jas03/LED-cube/README.md

# LED-cube
Design project for ECE-411

A 3x3x3 tricolor LED Cube that responds to music.

Members:

Evan Yand
Matthew Konyndyk
Alex Mendez
Jasjit Singh
