jas03/LED-cube/project_images/Atmega328.png

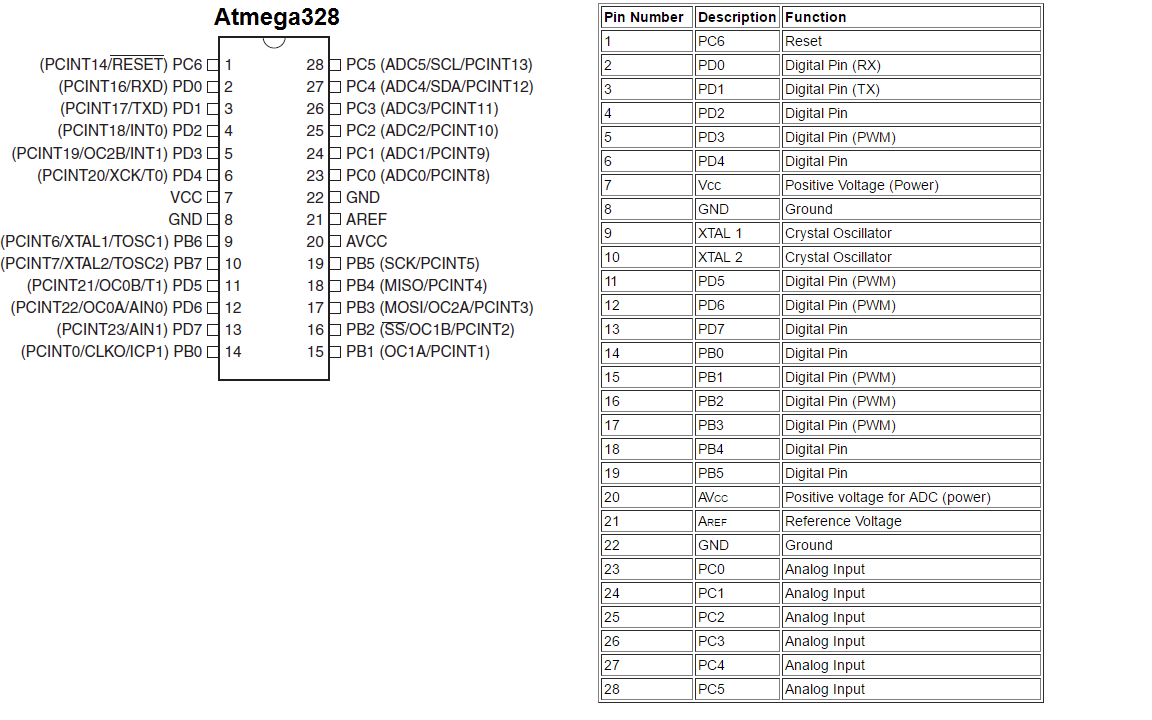
project_images/Atmega328.png
