jas03/LED-cube/project_images/atmega328_breadboard.png

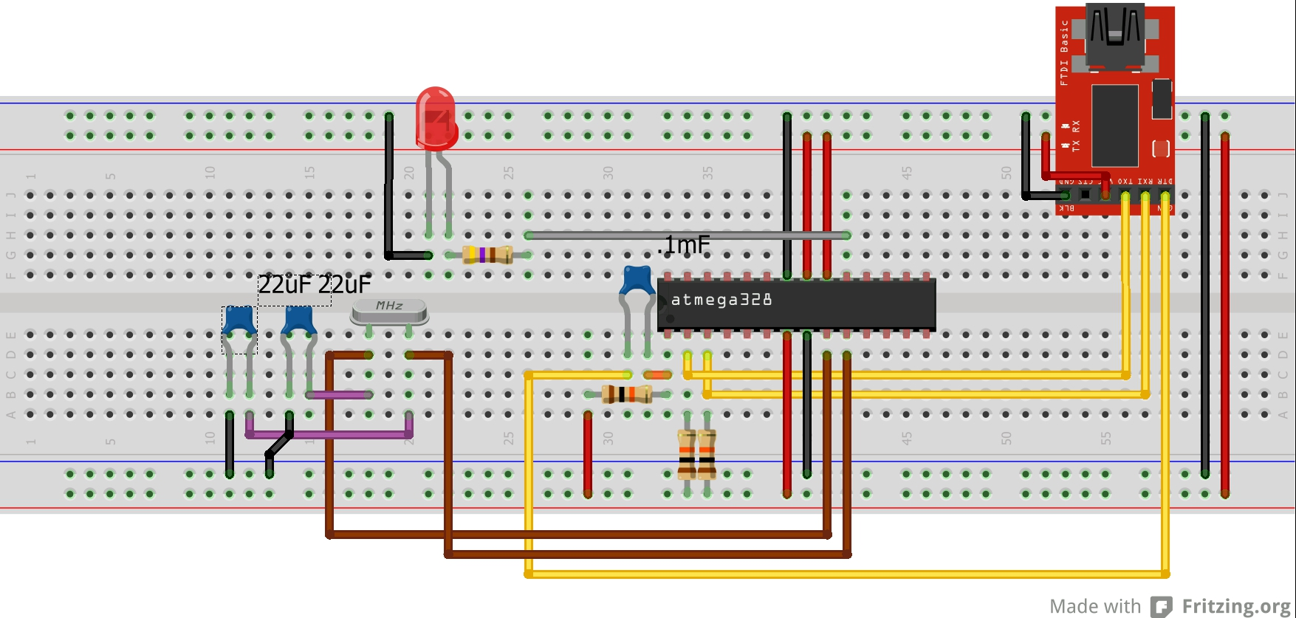
project_images/atmega328_breadboard.png
