jas03/LED-cube/project_images/Bread-Board-Arduino-Circuit.png

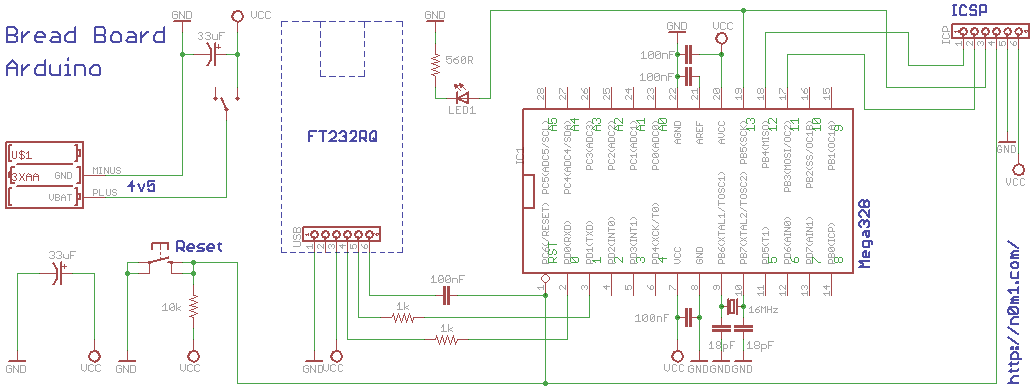
project_images/Bread-Board-Arduino-Circuit.png
