jas03/LED-cube/project_images/msgeq7.png

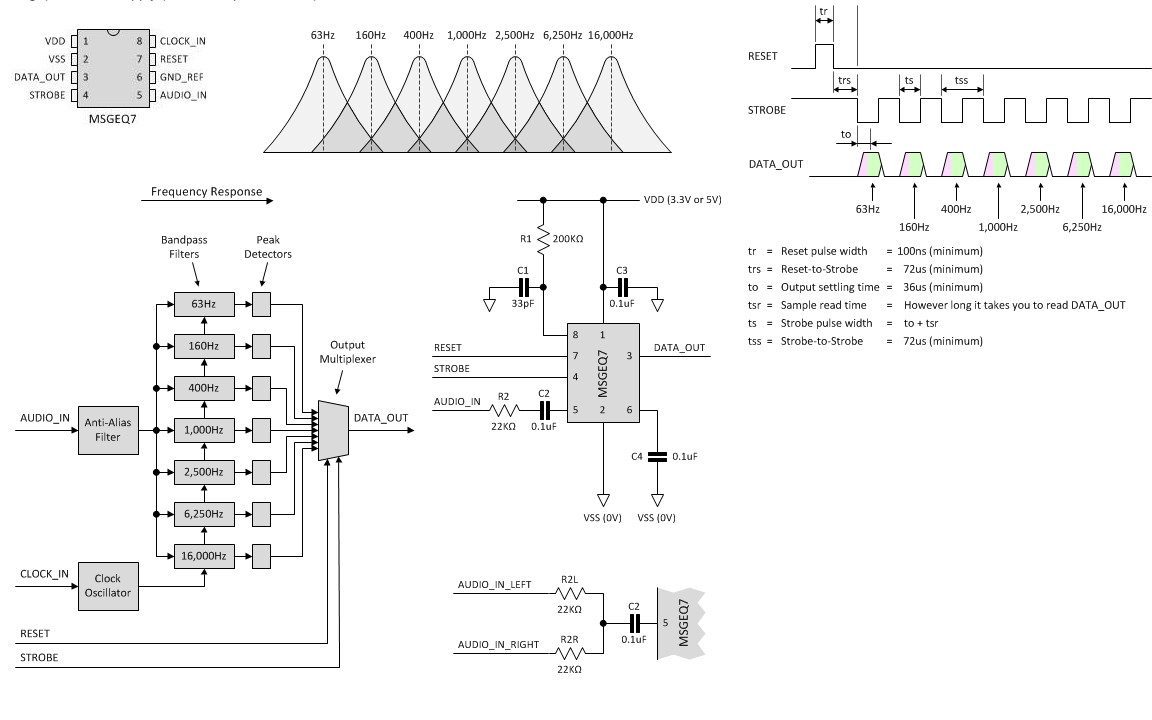
project_images/msgeq7.png
