jas03/LED-cube/project_images/tlc5940_2.png

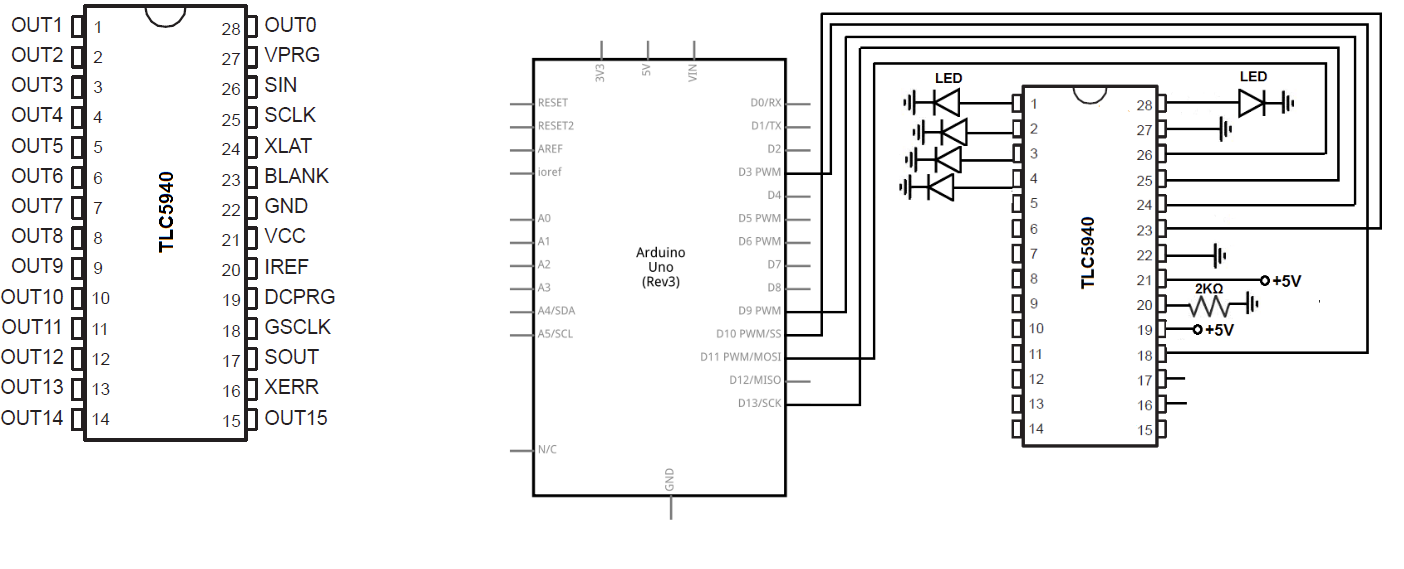
project_images/tlc5940_2.png
