jas03/LED-cube/BOM.xlsx

Sheet: Sheet1
Part | Value | Device | Package | Description | Cost @ 500 units
Components
C1 | 10nF | C-EUC0805 | C0805 | Capacitor | 0.0099
C2 | .15uF | C-EUC0402 | C0402 | Capacitor | 0.0099
C3 | 1uF | C-EUC0805 | C0805 | Capacitor | 0.0099
C4 | .15uF | C-EUC0402 | C0402 | Capacitor | 0.0099
C5 | 22pF | C-EUC0805 | C0805 | Capacitor | 0.0099
C6 | .15uF | C-EUC0402 | C0402 | Capacitor | 0.0099
C7 | .1uF | C-EUC0805 | C0805 | Capacitor | 0.0099
C8 | .15uF | C-EUC0402 | C0402 | Capacitor | 0.0099
C9 | 22pF | C-EUC0805 | C0805 | Capacitor | 0.0099
C10 | 33pF | C-EUC0805 | C0805 | Capacitor | 0.0099
C11 | .15uF | C-EUC0402 | C0402 | Capacitor | 0.0099
C12 | .15uF | C-EUC0402 | C0402 | Capacitor | 0.0099
R1 | 22k | R-US_R0805 | R0805 | Resistor | 0.0029
R2 | 22k | R-US_R0805 | R0805 | Resistor | 0.0029
R3 | 200k | R-US_R0805 | R0805 | Resistor | 0.0029
R4 | 4.7k | R-US_R0805 | R0805 | Resistor | 0.0029
R5 | 1k | R-US_R0805 | R0805 | Resistor | 0.0029
R6 | 1.9k | R-US_R0402 | R0402 | Resistor | 0.0029
R7 | 1.9k | R-US_R0402 | R0402 | Resistor | 0.0029
R8 | 1k | R-US_R0805 | R0805 | Resistor | 0.0029
R9 | 0 | R-US_R1210 | R1210 | Resistor | 0.0029
R10 | 1k | R-US_R0805 | R0805 | Resistor | 0.0029
R11 | 0 | R-US_R0402 | R0402 | Resistor | 0.0029
R12 | 0 | R-US_R0402 | R0402 | Resistor | 0.0029
R13 | 0 | R-US_R0402 | R0402 | Resistor | 0.0029
R14 | 0 | R-US_R0402 | R0402 | Resistor | 0.0029
JP1 | SPI | PINHD-2X3 | 2X03 | Pin Header | 0.1342
JP2 | SERIAL | PINHD-1X6 | 1X06 | Pin Header | 0.69612
JP3 | LED_R | PINHD-1X9 | 1X09 | Pin Header
JP4 | LED_G | PINHD-1X9 | 1X09 | Pin Header |  | Not in Final Design
JP5 | LED_B | PINHD-1X9 | 1X09 | Pin Header
JP6 | LED_SUPPLY | PINHD-1X3 | 1X03 | Pin Header
Q1 | 16MHz | CRYSTALHC49UP | HC49UP | CRYSTAL | 0.15884
Q2 | IRF9530 | IRF9530 | TO220BV | P-Channel Power MOSFET | 0.7961
Q3 | IRF9530 | IRF9530 | TO220BV | P-Channel Power MOSFET | 0.7961
Q4 | IRF9530 | IRF9530 | TO220BV | P-Channel Power MOSFET | 0.7961
IC1 | MSGEQ7SOIC | MSGEQ7SOIC | SOIC8 | 7-band Graphic equalizer | 4.46
U1 | ATMEGA328P-AU | ATMEGA328P-AU | QFP80P-32N | 8-bit Microcontroller | 2.26052
U2 | TLC5940-RHB | TLC5940-RHB | QFN-32 | 16-channel LED Driver | 1.76986
U3 | TLC5940-RHB | TLC5940-RHB | QFN-32 | 16-channel LED Driver | 1.76986
X1 | 1503_02 | 1503_02 | 1503_02 | 3.5mm Jack | 0.63558
J1 | POWER_JACKPTH | POWER_JACKPTH | POWER_JACK_PTH | Power | 0.81774
Additional Parts
PCB |  |  |  |  | 5
Case - Acrylic |  |  |  |  | 0.8
Case - Plastic |  |  |  |  | 2
DC Power Supply |  |  |  |  | 5.07
RGB LEDs | Qty:27 |  | 0.06 |  | 1.62
Additional Wire | Qty:15 in |  |  |  | 2.75
 |  |  |  | Total: | 29.74042
 |  |  | Estimate @ 10000 Units: |  | 14.87021

Sheet: Sheet2
 | 500 @ $45 |  |  | 10000 @ $30 |  |  | 10000 @ $45
Production Cost | 29.74042 | x 500 = | 14870.21 | 14.87021 | x10000 | 148702.1 | 14.87021 | x10000 | 148702.1
Setup/Labor |  |  | 2200 |  |  | 8000 |  |  | 8000
Gross | 45 | x 500 = | 22500 | 30 | x10000 | 300000 | 45 | x10000 | 450000
Net |  |  | 9829.79 |  |  | 159297.9 |  |  | 309297.9
