jas03/LED-cube/LED Cube Expenses.xlsx

Part | Quantity | Cost per unit | Shipping | Total Cost | Vendor | Purchased by
Mudder 0.6mm Solder Wire | 1 | 12.59 | 0 | 12.59 | Amazon.com | MK
flux | 1 | 2.96 | 0 | 2.96 | Amazon.com | MK
USB TTL serial adaptor for arduino | 1 | 3.94 | 0 | 3.94 | Amazon.com | MK
100 pieces RGB LEDs | 4 | 4.99 | 1.3 | 21.26 | EBAY | MK
10 pieces TLC5940 | 2 | 12.98 | 3.7 | 29.66 | EBAY | MK
5 pieces 9x15cm protoyping board | 2 | 2.86 | 1.85 | 7.57 | EBAY | MK
10 pieces MOSFET p channel transistors | 2 | 4.95 | 3 | 12.9 | EBAY | MK
