jas03/LED-cube/SolidWorks/cube.SLDPRT

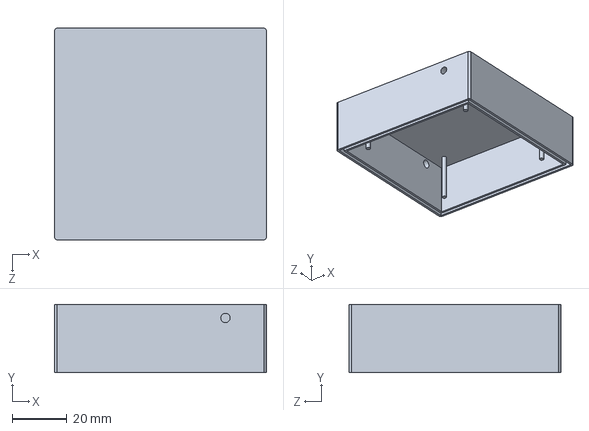
[picture p7: CAD file, 2016-11-17]
SolidWorks/cube.SLDPRT
77.5 x 25.0 x 77.5 mm
