jas03/LED-cube/SolidWorks/LED_Cube_Template_v2.SLDPRT

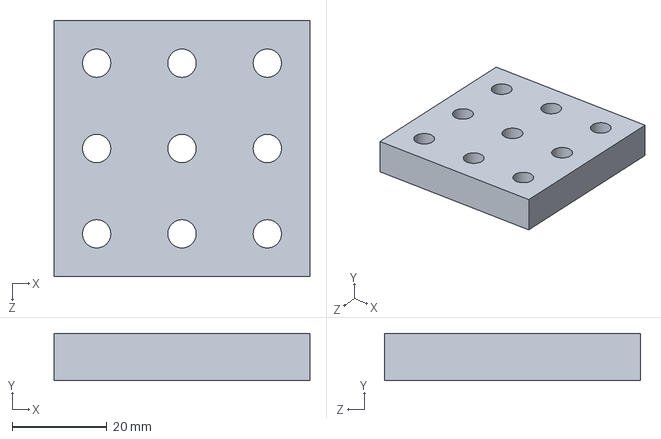
[picture p8: CAD file, 2016-10-30]
SolidWorks/LED_Cube_Template_v2.SLDPRT
54.0 x 10.0 x 54.0 mm
