jas03/LED-cube/(list of files, cad)

Other CAD files:
SolidWorks/cube-print.STL
SolidWorks/cube-drw.SLDDRW
