jas03/LED-cube/SolidWorks/cube-drw-pdf.pdf

7 7
B B

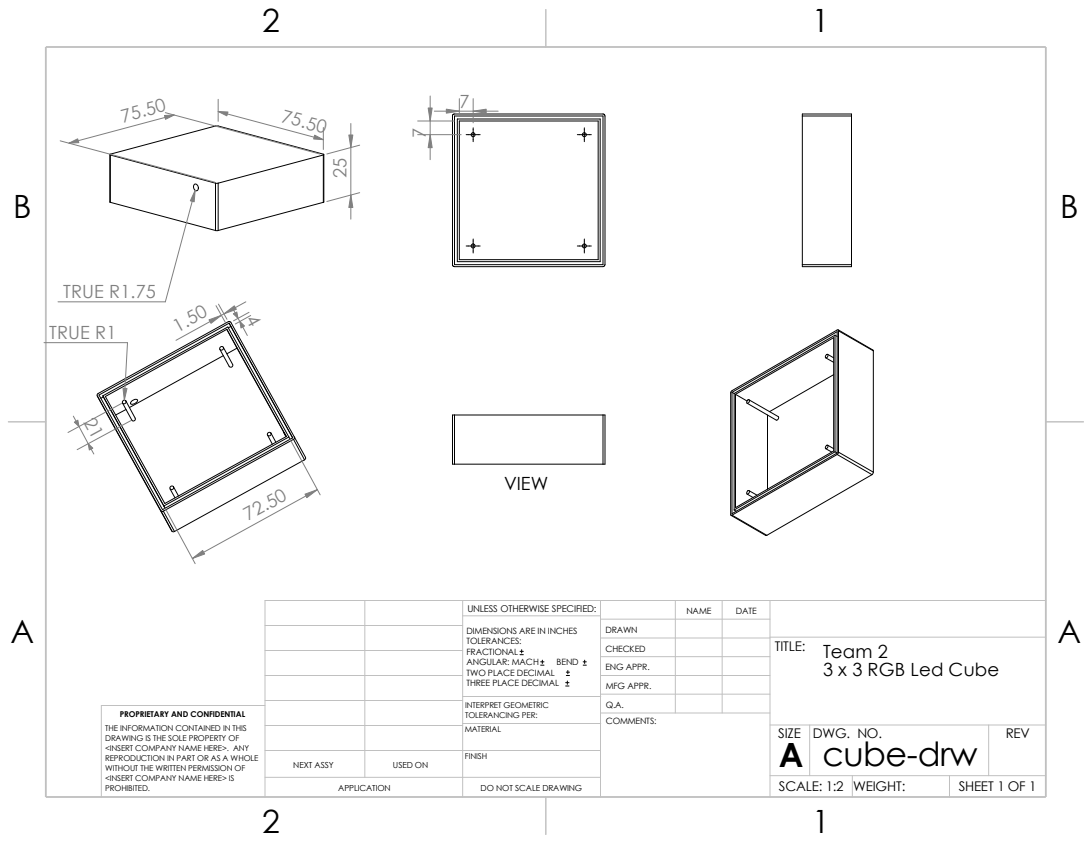
[picture p9: page 1]
TRUE R1.75; TRUE R1; DO NOT SCALE DRAWING; WEIGHT:; SHEET 1 OF 1; SCALE: 1:2; DWG. NO.; REV; SIZE; COMMENTS:; PROHIBITED.; VIEW

UNLESS OTHERWISE SPECIFIED:

NAME | DATE | Team 2 TITLE:
CHECKED | | | 3 x 3 RGB Led Cube
ENG APPR.
MFG APPR.
FINISH | A | cube-drw

DIMENSIONS ARE IN INCHES TOLERANCES: FRACTIONAL ANGULAR: MACH BEND TWO PLACE DECIMAL THREE PLACE DECIMAL | DRAWN

INTERPRET GEOMETRIC TOLERANCING PER: MATERIAL | Q.A.

PROPRIETARY AND CONFIDENTIAL
THE INFORMATION CONTAINED IN THIS
DRAWING IS THE SOLE PROPERTY OF
<INSERT COMPANY NAME HERE>. ANY
REPRODUCTION IN PART OR AS A WHOLE
WITHOUT THE WRITTEN PERMISSION OF
<INSERT COMPANY NAME HERE> IS

NEXT ASSY | USED ON
APPLICATION
