jas03/LED-cube/T02_LED_Cube.brd

## EAGLE design T02_LED_Cube.brd (2016-11-17)

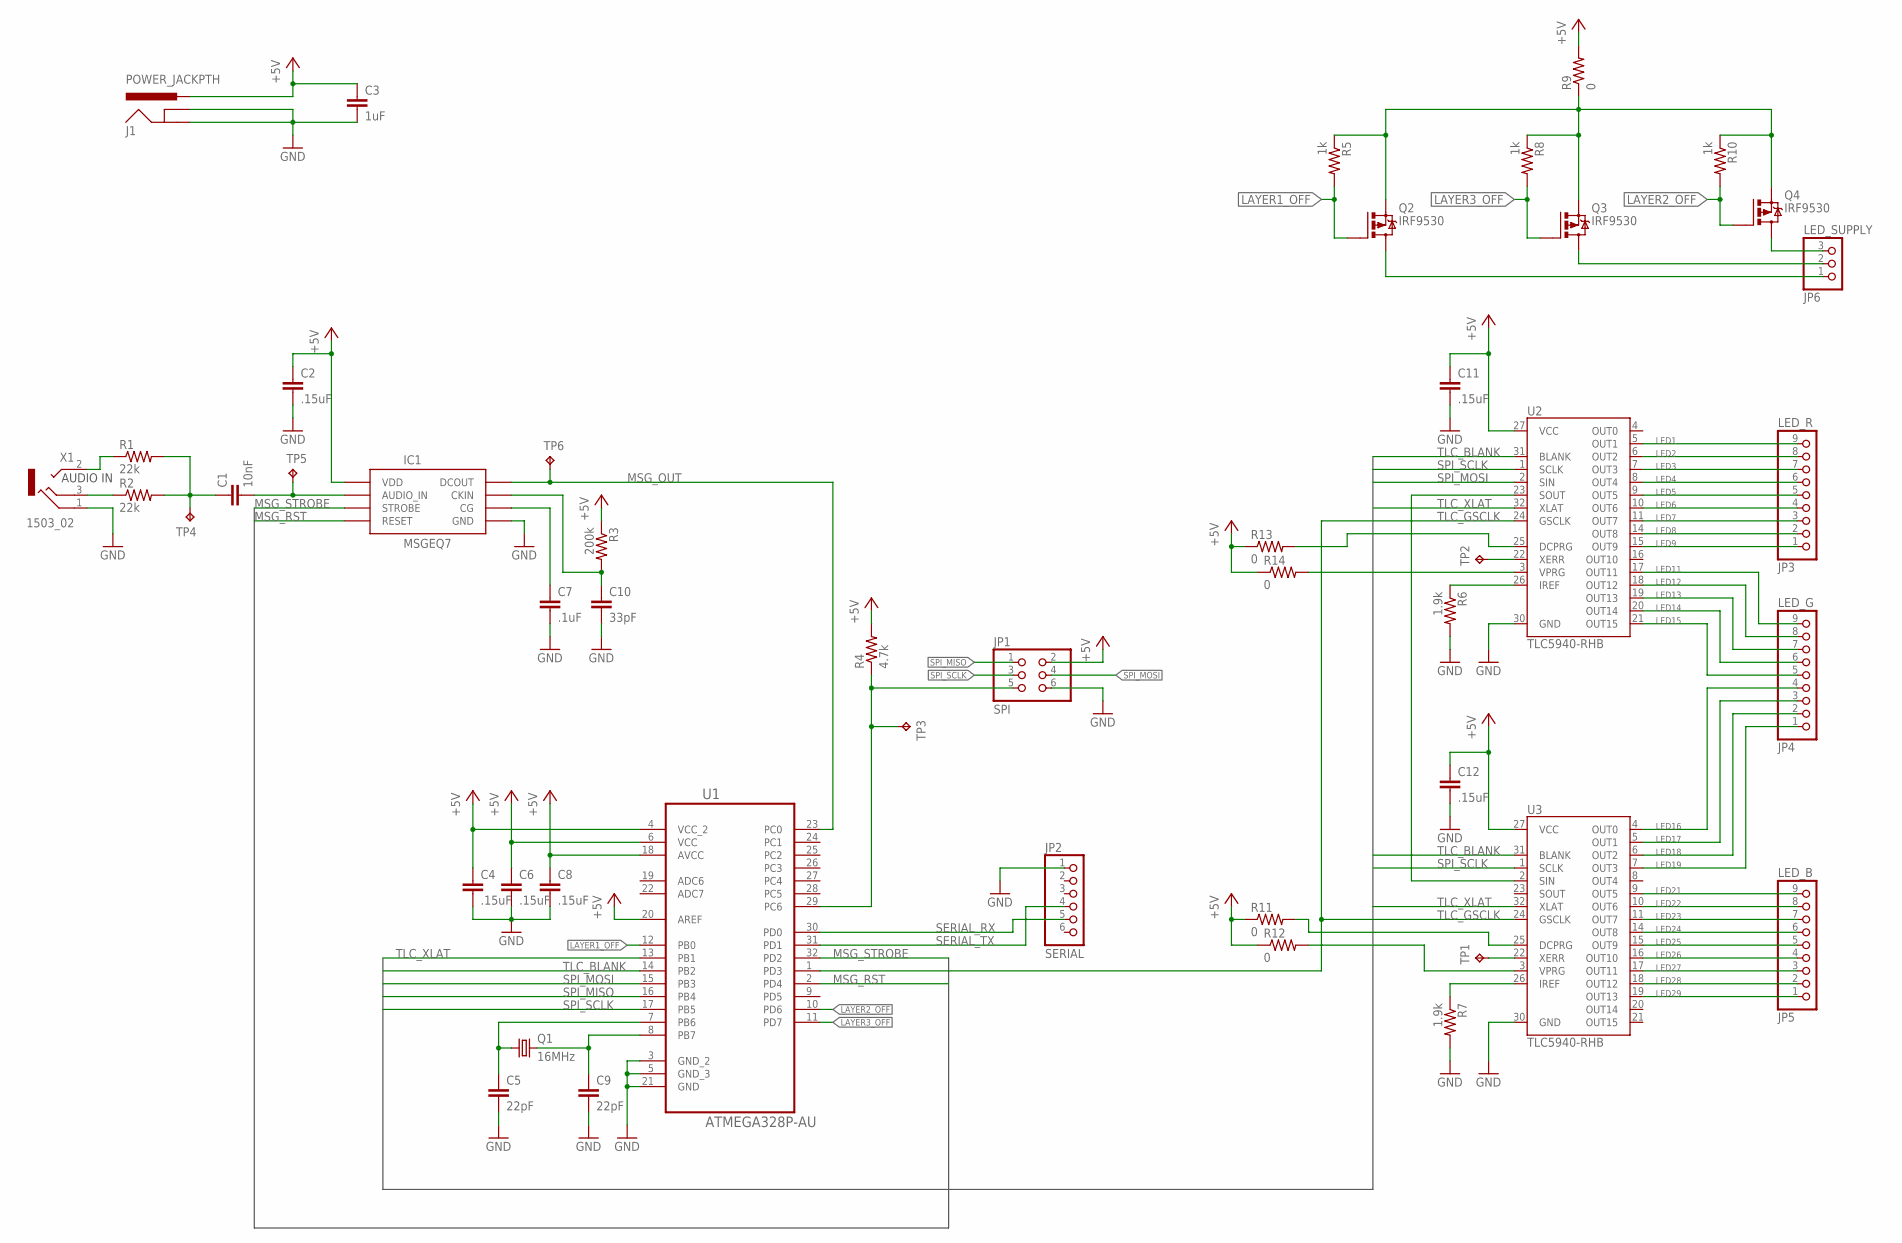
[picture p10: schematic T02_LED_Cube.sch]

Parts:
C1: 10nF; C0805
C2, C4, C6, C8, C11, C12: .15uF; C0402
C3: 1uF; C0805
C5, C9: 22pF; C0805
C7: .1uF; C0805
C10: 33pF; C0805
IC1: MSGEQ7SOIC; SOIC8
J1: POWER_JACKPTH; POWER_JACK_PTH
JP1: SPI; 2X03
JP2: SERIAL; 1X06
JP3: LED_R; 1X09
JP4: LED_G; 1X09
JP5: LED_B; 1X09
JP6: LED_SUPPLY; 1X03
Q1: 16MHz; HC49UP
Q2, Q3, Q4: IRF9530; TO220BV
R1, R2: 22k; R0805
R3: 200k; R0805
R4: 4.7k; R0805
R5, R8, R10: 1k; R0805
R6, R7: 1.9k; R0402
R9: 0; R1210
R11, R12, R13, R14: 0; R0402
TP1, TP2, TP3, TP4, TP5, TP6: TPPAD1-13; P1-13
U1: ATMEGA328P-AU; QFP80P900X900X120-32N
U2, U3: TLC5940-RHB; QFN-32
X1: 1503_02

Connections:
+5V: C2.1, C3.1, C4.1, C6.1, C8.1, C11.1, C12.1, IC1.1 (VDD), J1.PWR, JP1.2, R3.1, R4.2, R9.2, R11.1, R12.1, R13.1, R14.1, U1.4 (VCC_2), U1.6 (VCC), U1.18 (AVCC), U1.20 (AREF), U2.27 (VCC), U3.27 (VCC)
ATM_RST: JP1.5, R4.1, TP3.TP, U1.29 (PC6)
CRY_1: C5.1, Q1.1, U1.7 (PB6)
CRY_2: C9.1, Q1.2, U1.8 (PB7)
GND: C2.2, C3.2, C4.2, C5.2, C6.2, C7.2, C8.2, C9.2, C10.2, C11.2, C12.2, IC1.2 (GND), J1.GND, J1.GNDBREAK, JP1.6, JP2.1, R6.2, R7.2, U1.3 (GND_2), U1.5 (GND_3), U1.21 (GND), U2.30 (GND), U3.30 (GND), X1.1
LAY1_SUPPLY: JP6.1, Q2.D
LAY2_SUPPLY: JP6.3, Q4.D
LAY3_SUPPLY: JP6.2, Q3.D
LAYER1_OFF: Q2.G, R5.2, U1.12 (PB0)
LAYER2_OFF: Q4.G, R10.2, U1.10 (PD6)
LAYER3_OFF: Q3.G, R8.2, U1.11 (PD7)
LED1: JP3.9, U2.5 (OUT1)
LED2: JP3.8, U2.6 (OUT2)
LED3: JP3.7, U2.7 (OUT3)
LED4: JP3.6, U2.8 (OUT4)
LED5: JP3.5, U2.9 (OUT5)
LED6: JP3.4, U2.10 (OUT6)
LED7: JP3.3, U2.11 (OUT7)
LED8: JP3.2, U2.14 (OUT8)
LED9: JP3.1, U2.15 (OUT9)
LED11: JP4.9, U2.17 (OUT11)
LED12: JP4.8, U2.18 (OUT12)
LED13: JP4.7, U2.19 (OUT13)
LED14: JP4.6, U2.20 (OUT14)
LED15: JP4.5, U2.21 (OUT15)
LED16: JP4.4, U3.4 (OUT0)
LED17: JP4.3, U3.5 (OUT1)
LED18: JP4.2, U3.6 (OUT2)
LED19: JP4.1, U3.7 (OUT3)
LED21: JP5.9, U3.9 (OUT5)
LED22: JP5.8, U3.10 (OUT6)
LED23: JP5.7, U3.11 (OUT7)
LED24: JP5.6, U3.14 (OUT8)
LED25: JP5.5, U3.15 (OUT9)
LED26: JP5.4, U3.16 (OUT10)
LED27: JP5.3, U3.17 (OUT11)
LED28: JP5.2, U3.18 (OUT12)
LED29: JP5.1, U3.19 (OUT13)
LED_SUPPLY: Q2.S, Q3.S, Q4.S, R5.1, R8.1, R9.1, R10.1
MSG_CG: C7.1, IC1.6 (CG)
MSG_CKIN: C10.1, IC1.8 (CKIN), R3.2
MSG_INPUT: C1.2, IC1.5 (AUDIO_IN), TP5.TP
MSG_OUT: IC1.3 (DCOUT), TP6.TP, U1.23 (PC0)
MSG_RST: IC1.7 (RESET), U1.2 (PD4)
MSG_STROBE: IC1.4 (STROBE), U1.32 (PD2)
unnamed: R2.1, X1.3
unnamed: R1.1, X1.2
unnamed: R12.2, U3.3 (VPRG)
unnamed: R14.2, U2.3 (VPRG)
unnamed: R11.2, U3.25 (DCPRG)
unnamed: R13.2, U2.25 (DCPRG)
SERIAL_RX: JP2.5, U1.30 (PD0)
SERIAL_TX: JP2.4, U1.31 (PD1)
SPI_MISO: JP1.1, U1.16 (PB4)
SPI_MOSI: JP1.4, U1.15 (PB3), U2.2 (SIN)
SPI_SCLK: JP1.3, U1.17 (PB5), U2.1 (SCLK), U3.1 (SCLK)
TLC1_ERR: TP2.TP, U2.22 (XERR)
TLC1_IREF: R6.1, U2.26 (IREF)
TLC2_ERR: TP1.TP, U3.22 (XERR)
TLC2_IREF: R7.1, U3.26 (IREF)
TLC_BLANK: U1.14 (PB2), U2.31 (BLANK), U3.31 (BLANK)
TLC_CHAIN: U2.23 (SOUT), U3.2 (SIN)
TLC_GSCLK: U1.1 (PD3), U2.24 (GSCLK), U3.24 (GSCLK)
TLC_XLAT: U1.13 (PB1), U2.32 (XLAT), U3.32 (XLAT)
UNFILTERED_INPUT: C1.1, R1.2, R2.2, TP4.TP

Notes on the sheet:
AUDIO IN

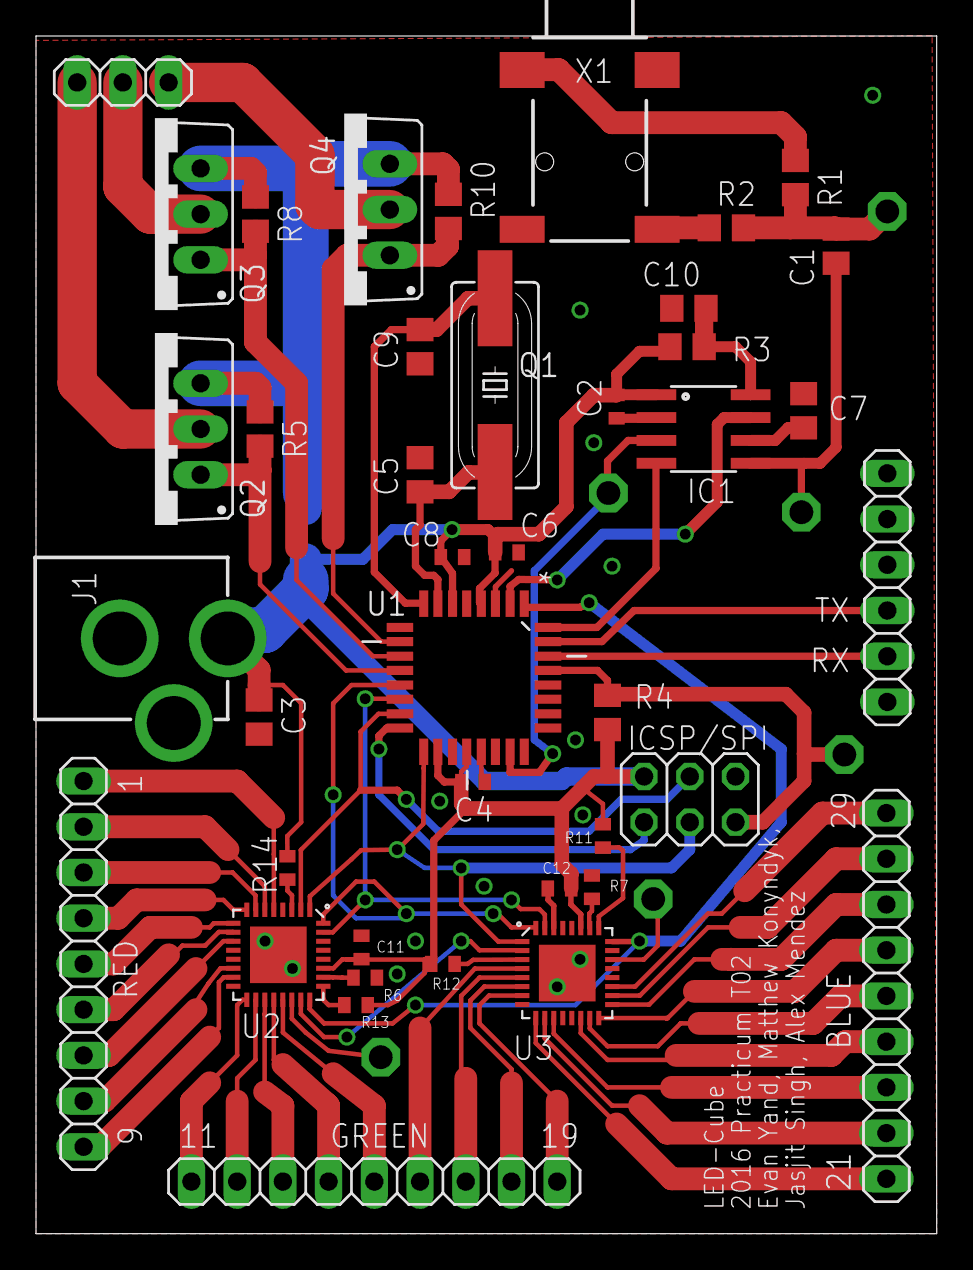
[picture p11: board T02_LED_Cube.brd from above]

Board: 2 copper layers, 50.0 x 66.5 mm, 48 parts (1 on the bottom side), 65 nets.
