jas03/LED-cube/Samples/Layers_are_different_colors/Declarations.ino

/*

#define AAr 0 //defines the red leds
#define ABr 1
#define ACr 2
#define BAr 3
#define BBr 4
#define BCr 5
#define CAr 6
#define CBr 7
#define CCr 8


#define AAg 0 //defines the green leds
#define ABg 1
#define ACg 2
#define BAg 3
#define BBg 4
#define BCg 5
#define CAg 6
#define CBg 7
#define CCg 8


#define AAb 0 //defines the blue leds
#define ABb 1
#define ACb 2
#define BAb 3
#define BBb 4
#define BCb 5
#define CAb 6
#define CBb 7
#define CCb 8


int AAAr = 0; //sets a variable for all red leds
int AABr = 0;
int AACr = 0;
int ABAr = 0;
int ABBr = 0;
int ABCr = 0;
int ACAr = 0;
int ACBr = 0;
int ACCr = 0;

int BAAr = 0; 
int BABr = 0;
int BACr = 0;
int BBAr = 0;
int BBBr = 0;
int BBCr = 0;
int BCAr = 0;
int BCBr = 0;
int BCCr = 0;

int CAAr = 0; 
int CABr = 0;
int CACr = 0;
int CBAr = 0;
int CBBr = 0;
int CBCr = 0;
int CCAr = 0;
int CCBr = 0;
int CCCr = 0;


int AAAg = 0; //sets a variable for all green leds
int AABg = 0;
int AACg = 0;
int ABAg = 0;
int ABBg = 0;
int ABCg = 0;
int ACAg = 0;
int ACBg = 0;
int ACCg = 0;

int BAAg = 0; 
int BABg = 0;
int BACg = 0;
int BBAg = 0;
int BBBg = 0;
int BBCg = 0;
int BCAg = 0;
int BCBg = 0;
int BCCg = 0;

int CAAg = 0; 
int CABg = 0;
int CACg = 0;
int CBAg = 0;
int CBBg = 0;
int CBCg = 0;
int CCAg = 0;
int CCBg = 0;
int CCCg = 0;


int AAAb = 0; //sets a variable for all blue leds
int AABb = 0;
int AACb = 0;
int ABAb = 0;
int ABBb = 0;
int ABCb = 0;
int ACAb = 0;
int ACBb = 0;
int ACCb = 0;

int BAAb = 0; 
int BABb = 0;
int BACb = 0;
int BBAb = 0;
int BBBb = 0;
int BBCb = 0;
int BCAb = 0;
int BCBb = 0;
int BCCb = 0;

int CAAb = 0; 
int CABb = 0;
int CACb = 0;
int CBAb = 0;
int CBBb = 0;
int CBCb = 0;
int CCAb = 0;
int CCBb = 0;
int CCCb = 0;


int REDLEDs[]={AAAr,AABr,AACr,ABAr,ABBr,ABCr,ACAr,ACBr,ACCr,BAAr,BABr,BACr,BBAr,BBBr,BBCr,BCAr,BCBr,BCCr,CAAr,CABr,CACr,CBAr,CBBr,CBCr,CCAr,CCBr,CCCr};

int GREENLEDs[]={AAAg,AABg,AACg,ABAg,ABBg,ABCg,ACAg,ACBg,ACCg,BAAg,BABg,BACg,BBAg,BBBg,BBCg,BCAg,BCBg,BCCg,CAAg,CABg,CACg,CBAg,CBBg,CBCg,CCAg,CCBg,CCCg};
                 
int BLUELEDs[]={AAAb,AABb,AACb,ABAb,ABBb,ABCb,ACAb,ACBb,ACCb,BAAb,BABb,BACb,BBAb,BBBb,BBCb,BCAb,BCBb,BCCb,CAAb,CABb,CACb,CBAb,CBBb,CBCb,CCAb,CCBb,CCCb};
                
*/
