jas03/LED-cube/(commit log)

2016-10-06 RGB LED datasheet
    The attached datasheet should help us understand the RGB LEDs a bit more and how they can be controlled.
2016-10-08 schematic Rev 0
    [LED_Cube.sch]
2016-10-08 MSGEQ7 Set up
    [LED_Cube.sch]
2016-10-08 Datasheets folder addition
    Just shoving the LEDs into a new folder for easier reference
2016-10-08 1/3 TLC5940 set up
    [LED_Cube.sch]
2016-10-13 began ATMEGA integration into schemaic. Specified tenative pins
    [LED_Cube.sch]
2016-10-13 further atmega connections
    [LED_Cube.sch]
2016-10-15 Schematic almost done
    [LED_Cube.sch]
2016-10-17 more schematic
    [LED_Cube.sch]
2016-10-23 schematic & board updated
    [LED_Cube.sch]
2016-10-23 new board [15%]
    [LED_Cube.brd]
2016-10-23 schematic 80%/board 25%
    [LED_Cube.brd, LED_Cube.sch]
2016-10-23 schematic 80%/board 35%
    [LED_Cube.brd, LED_Cube.sch]
2016-10-27 Update of Sample Codes
2016-10-31 LED Cube Proof of Concept
    This program should show how our LED cube is going to work, using a basic pattern to demonstrate how the LED cube can be controlled by an audio signal.
2016-11-01 prelim schematic done. second draft of board [50%]
    [LED_Cube.brd, LED_Cube.sch]
2016-11-03 renamed files with prefix; added busses to sch
    [T02_LED_Cube.brd, T02_LED_Cube.sch]
2016-11-05 pcb 75% done
    [LED_Cube.brd, LED_Cube.sch, T02_LED_Cube.brd, T02_LED_Cube.sch]
2016-11-14 board 95% besides stitching
    [T02_LED_Cube.brd]
2016-11-17 submitted board
    [T02_LED_Cube.brd, T02_LED_Cube.sch]
2016-11-17 fixed some text
    [T02_LED_Cube.brd]
2016-12-09 Added BOM
    [BOM.xlsx]
